YetAnotherUser24/nodo-mezclador/scripts/results/figures/pso/sysid_itae_step.png

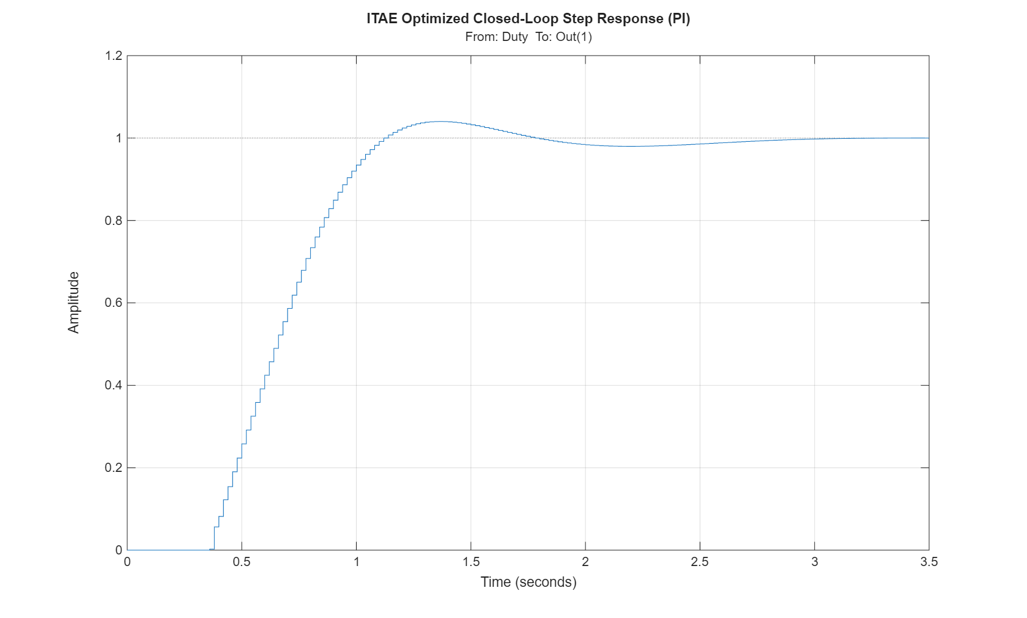
scripts/results/figures/pso/sysid_itae_step.png
