YetAnotherUser24/nodo-mezclador/scripts/data/closed_loop_test.csv

Time_s | Target_Duty | Compensated_Duty | Rad_s
0.000 | 0.0400 | 0.2841 | 0.0000
0.020 | 0.0800 | 0.3140 | 0.0000
0.040 | 0.1200 | 0.3439 | 0.0000
0.060 | 0.1600 | 0.3738 | 0.0000
0.080 | 0.2000 | 0.4036 | 0.0000
0.100 | 0.2400 | 0.4334 | 0.0000
0.120 | 0.2800 | 0.4632 | 0.0000
0.140 | 0.3200 | 0.4930 | 0.0000
0.160 | 0.3600 | 0.5228 | 0.0000
0.180 | 0.4000 | 0.5525 | 0.0000
0.200 | 0.4400 | 0.5822 | 0.0000
0.220 | 0.4800 | 0.6119 | 29.0946
0.240 | 0.5200 | 0.6415 | 29.0946
0.260 | 0.5600 | 0.6712 | 31.1126
0.280 | 0.6000 | 0.7008 | 31.8478
0.300 | 0.6400 | 0.7304 | 32.2286
0.320 | 0.6800 | 0.7599 | 32.2286
0.340 | 0.7000 | 0.7747 | 32.4605
0.360 | 0.7400 | 0.8043 | 23.2250
0.380 | 0.7800 | 0.8338 | 23.2250
0.400 | 0.8200 | 0.8632 | 36.1468
0.420 | 0.8600 | 0.8927 | 40.3071
0.440 | 0.9000 | 0.9222 | 58.3007
0.460 | 0.9400 | 0.9516 | 61.0985
0.480 | 0.9800 | 0.9810 | 65.7485
0.500 | 1.0000 | 0.9957 | 76.1257
0.520 | 1.0000 | 0.9957 | 86.0427
0.540 | 1.0000 | 0.9957 | 99.6114
0.560 | 1.0000 | 0.9957 | 106.7425
0.580 | 1.0000 | 0.9957 | 117.9498
0.600 | 1.0000 | 0.9957 | 127.3731
0.620 | 1.0000 | 0.9957 | 136.2267
0.640 | 0.9660 | 0.9707 | 145.1484
0.660 | 0.9592 | 0.9656 | 155.0523
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
