YetAnotherUser24/nodo-mezclador/scripts/results/figures/pidtune/closed_loop_validation copy.png

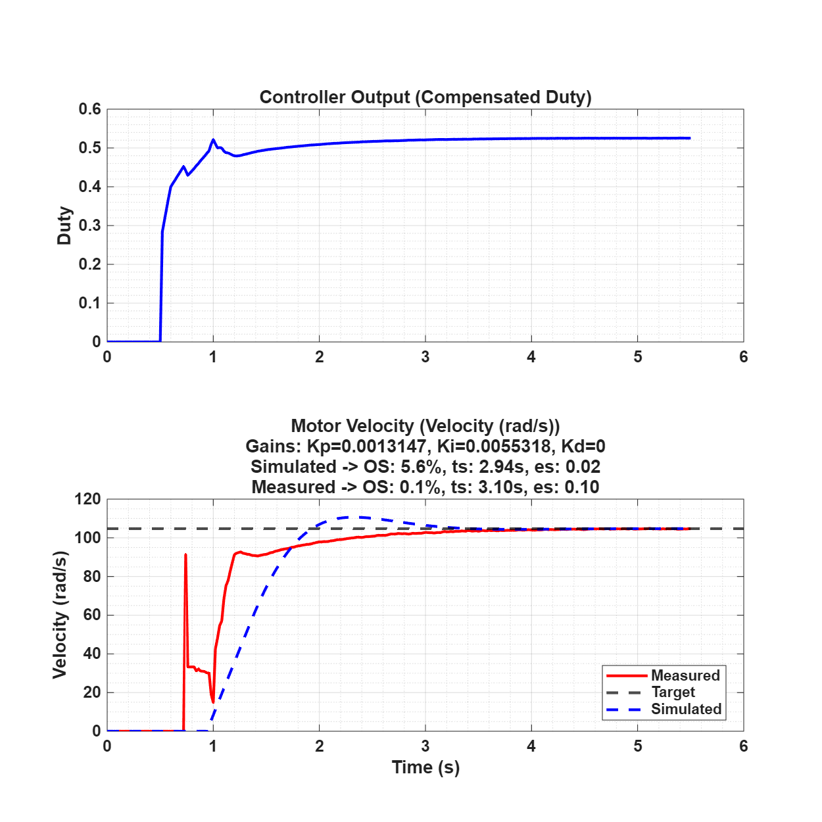
scripts/results/figures/pidtune/closed_loop_validation copy.png
