YetAnotherUser24/nodo-mezclador/scripts/results/figures/pidtune/closed_loop_validation_new_plant.png

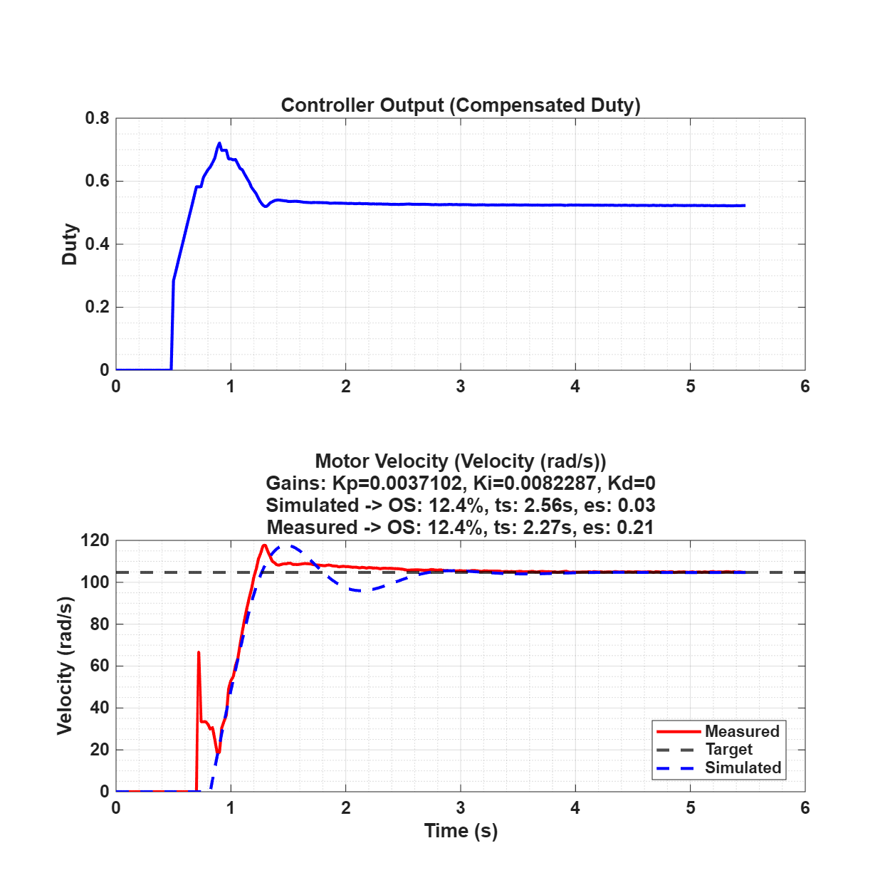
scripts/results/figures/pidtune/closed_loop_validation_new_plant.png
