YetAnotherUser24/nodo-mezclador/scripts/results/figures/pidtune/closed_loop_validation_open_air.png

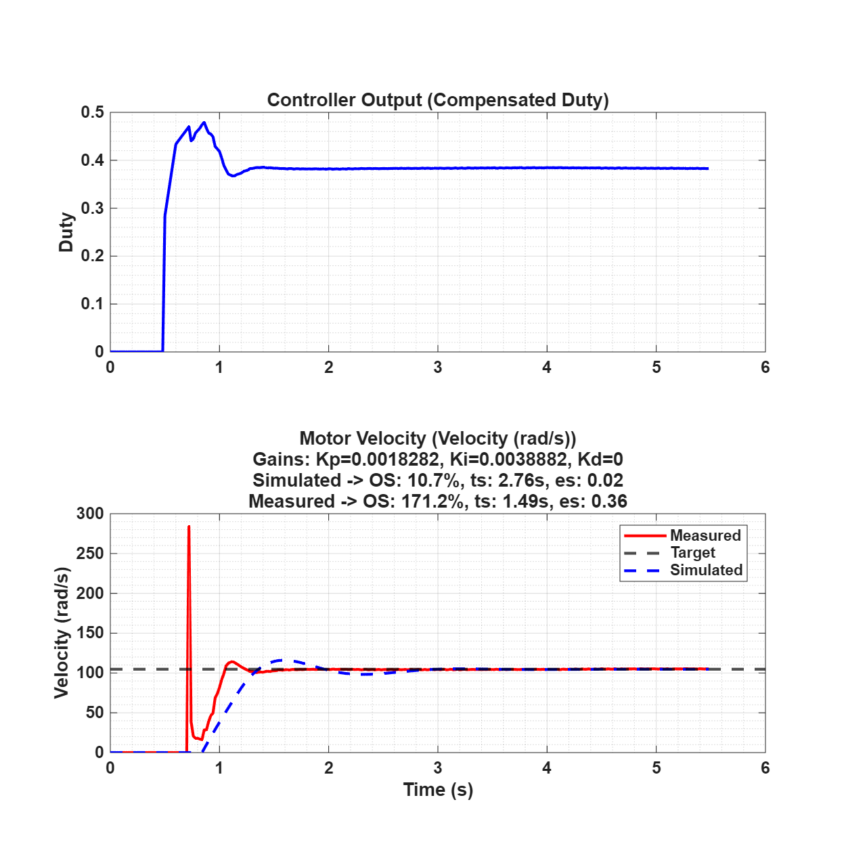
scripts/results/figures/pidtune/closed_loop_validation_open_air.png
