YetAnotherUser24/nodo-mezclador/scripts/results/figures/pidtune/sysid_closed_loop.png

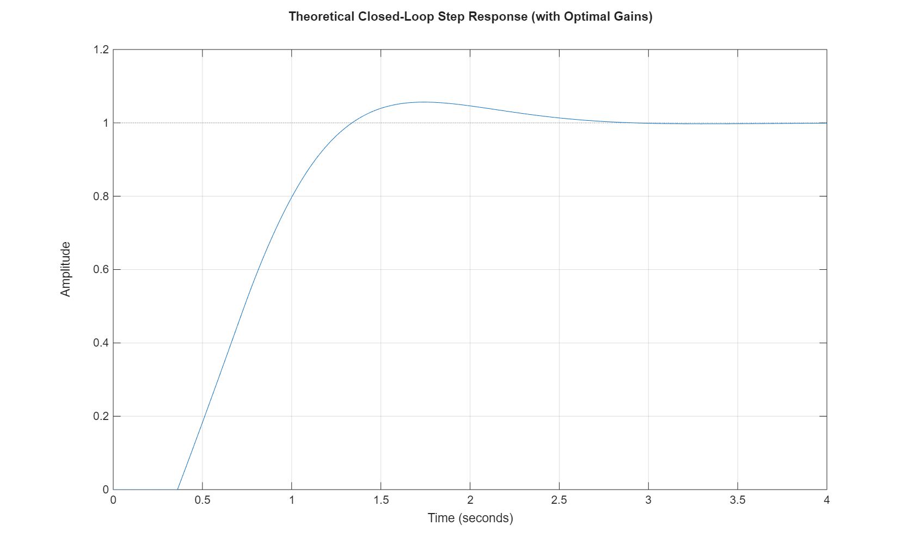
scripts/results/figures/pidtune/sysid_closed_loop.png
