YetAnotherUser24/nodo-mezclador/scripts/results/figures/pidtune/sysid_model_fit.png

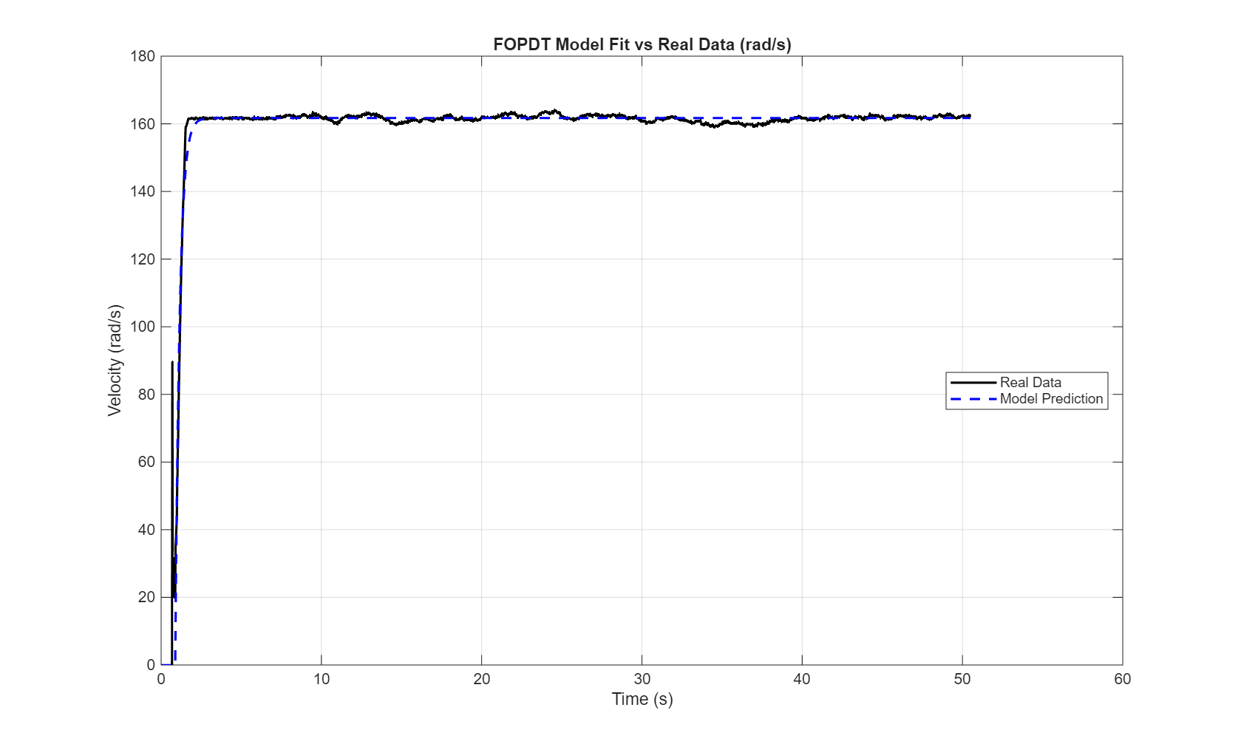
scripts/results/figures/pidtune/sysid_model_fit.png
