YetAnotherUser24/nodo-mezclador/scripts/results/figures/pidtune/sysid_raw_data.png

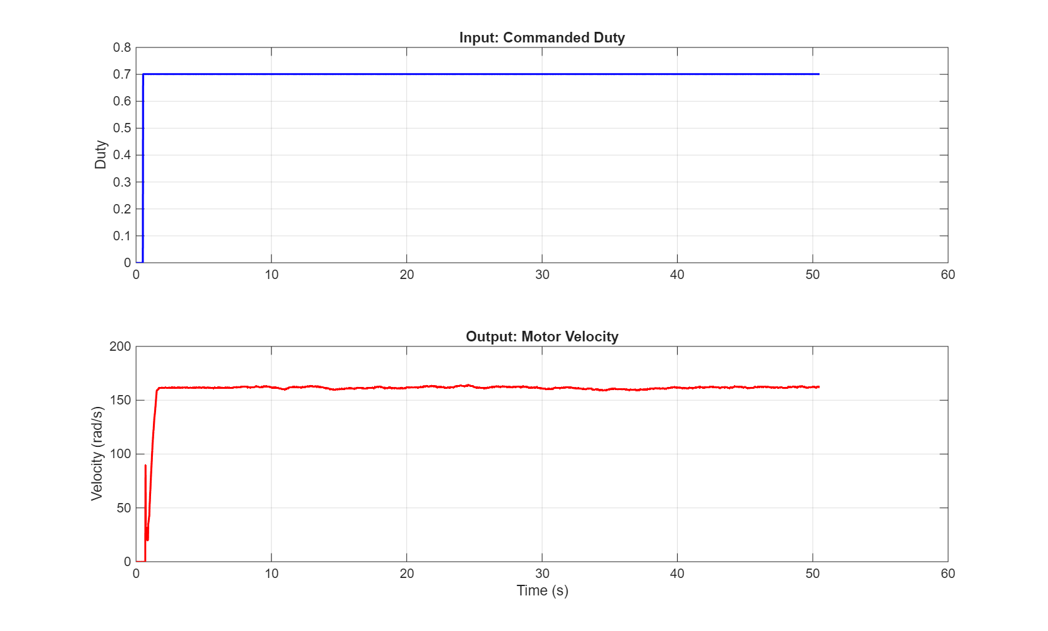
scripts/results/figures/pidtune/sysid_raw_data.png
