YetAnotherUser24/nodo-mezclador/scripts/results/figures/pso/closed_loop_validation_new_plant.png

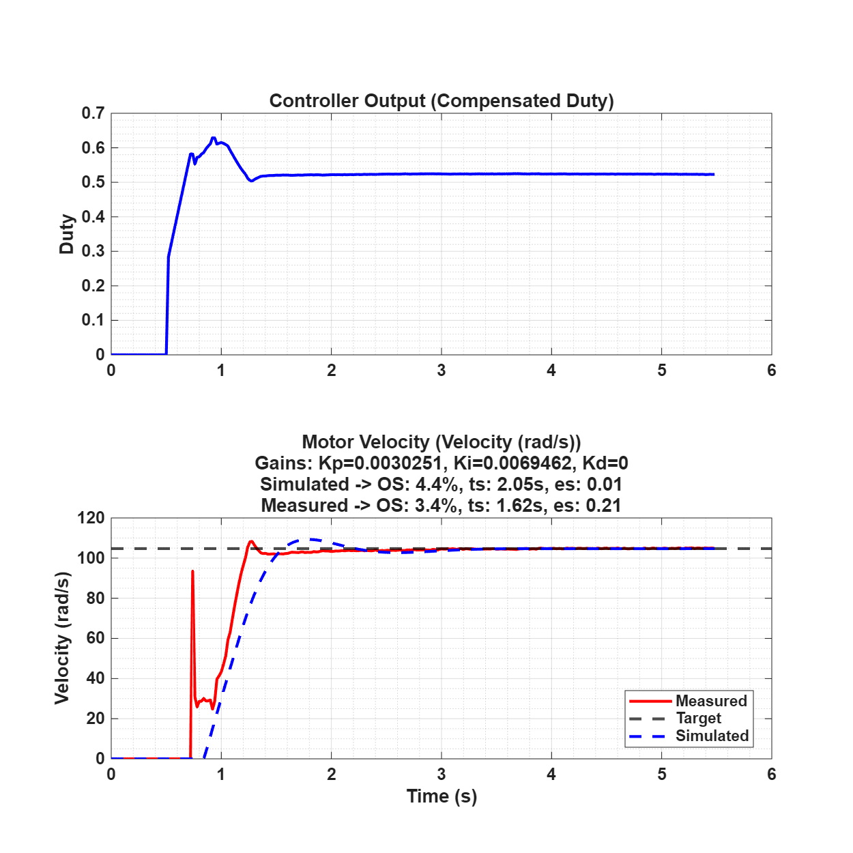
scripts/results/figures/pso/closed_loop_validation_new_plant.png
