YetAnotherUser24/nodo-mezclador/scripts/results/figures/pso/closed_loop_validation_open_air.png

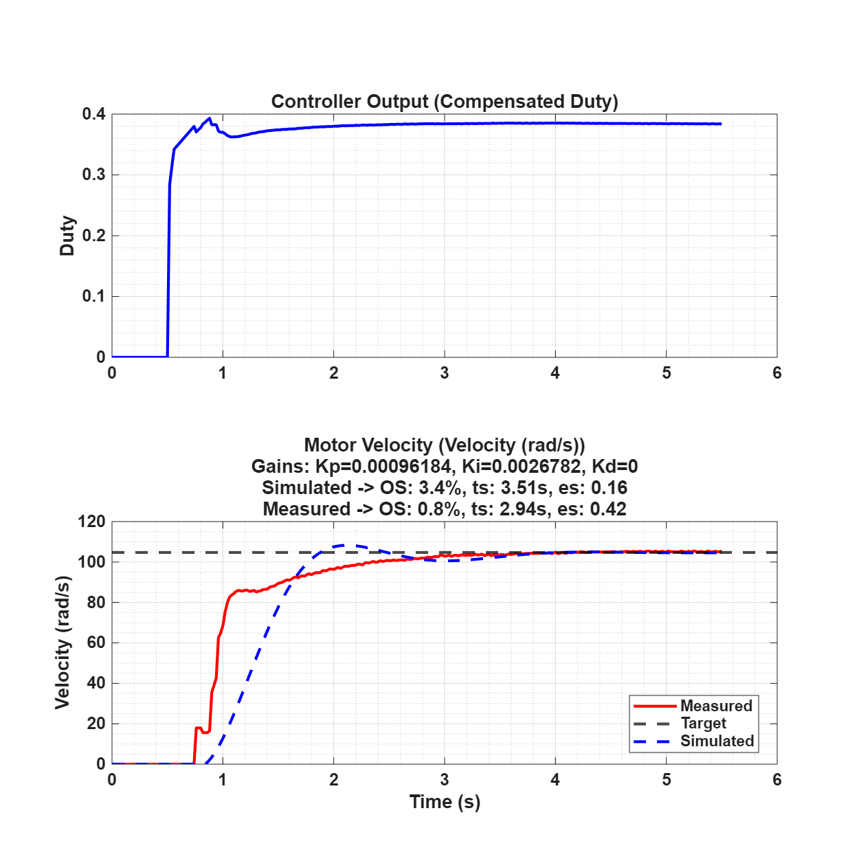
scripts/results/figures/pso/closed_loop_validation_open_air.png
