YetAnotherUser24/nodo-mezclador/scripts/results/figures/pso/optimization_comparison.png

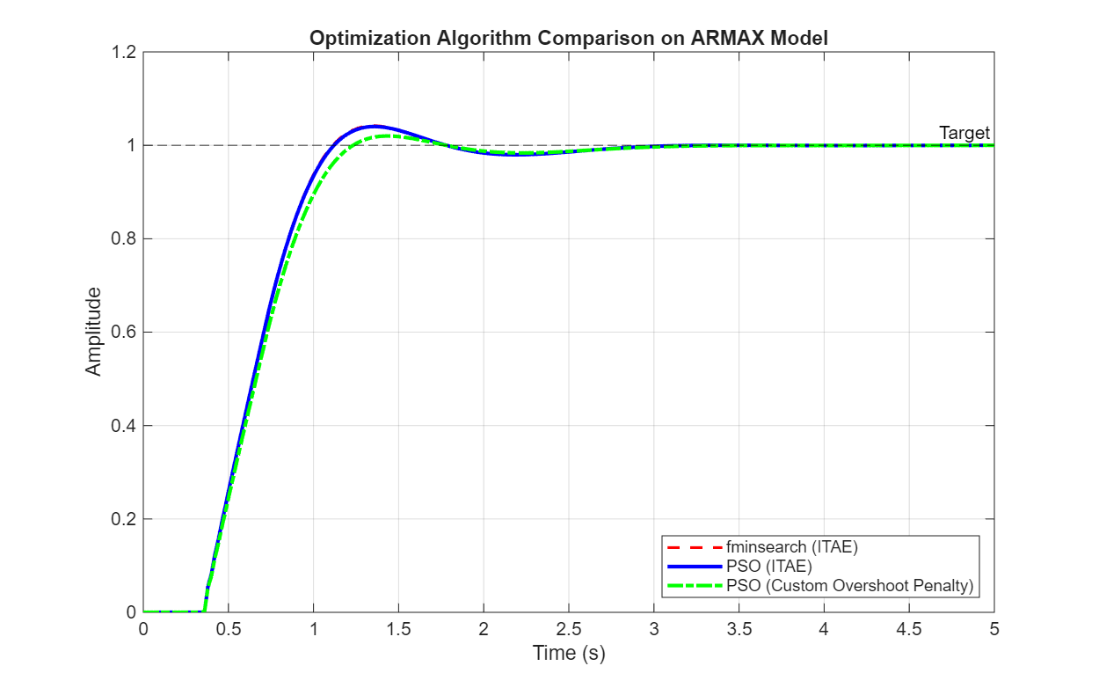
scripts/results/figures/pso/optimization_comparison.png
