YetAnotherUser24/nodo-mezclador/scripts/results/figures/pso/sysid_model_comparison.png

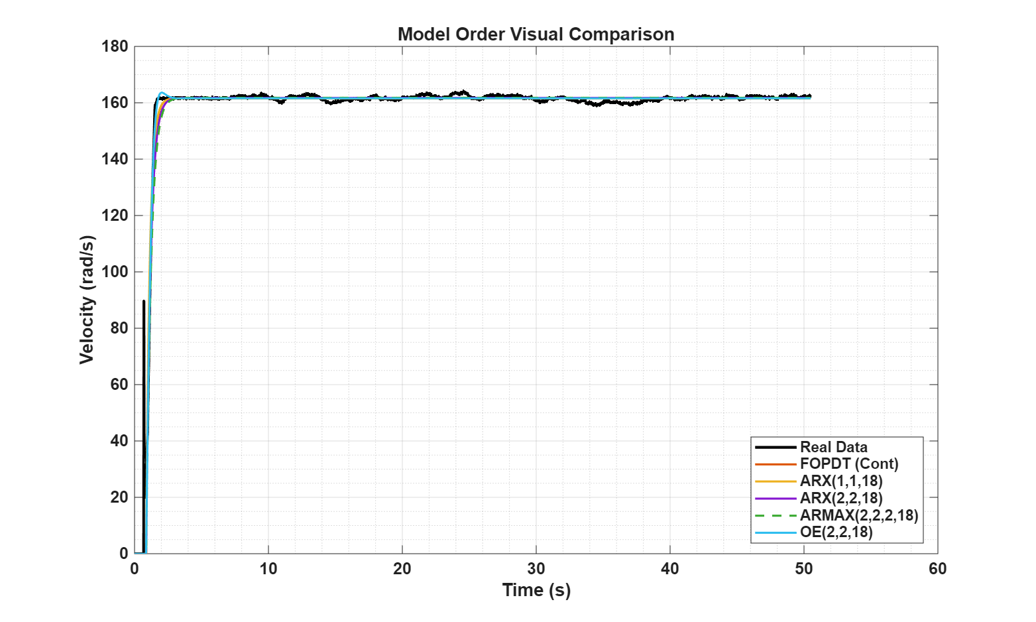
scripts/results/figures/pso/sysid_model_comparison.png
