YetAnotherUser24/nodo-mezclador/scripts/results/figures/pso/sysid_model_fit.png

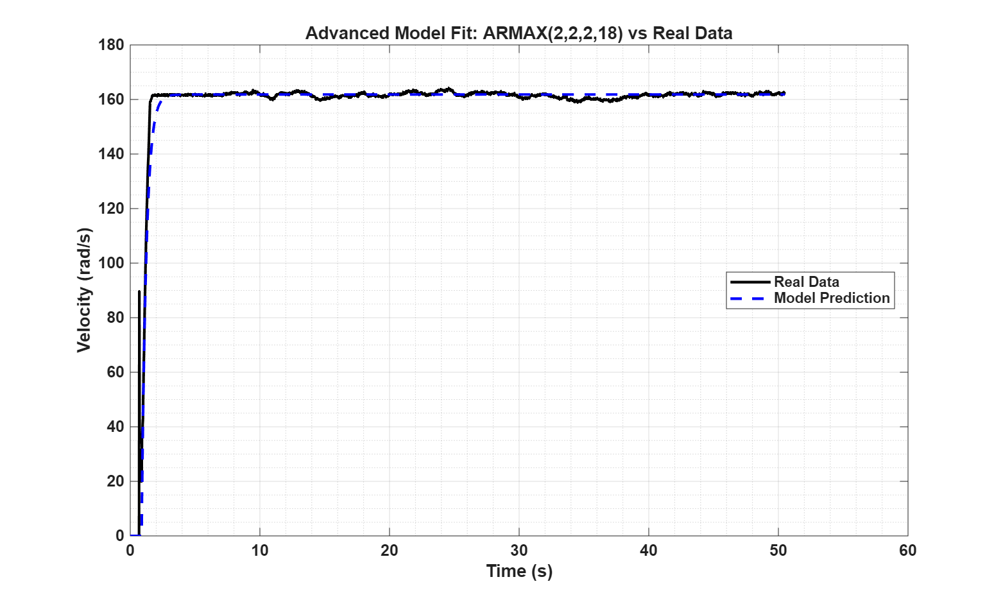
scripts/results/figures/pso/sysid_model_fit.png
