YetAnotherUser24/nodo-mezclador/(commit log)

2026-09-07 feat: initial commit for T-200 thruster velocity controller and SNR8503M driver interface
2026-10-03 feat: implement closed-loop velocity controller and reciprocal FG tachometer for T-200 thruster
2026-10-03 fix: change 220 pull up to 200
    [esp32s3_main.cpp]
2026-10-03 feat: add stall recovery, FG fault decoding, and analog knob override
    - Implemented stall fault auto-recovery by forcing 0% PWM on stall
    - Added FG fault pulse decoder to identify specific ESC errors (Stall, Overcurrent, etc)
    - Updated telemetry to display real-time ESC state machine status
    - Added analog knob manual override on GPIO 4 with 0->100->0 unlock sequence and 5s inactivity lockout
    - Updated MOTOR_MIN_SPIN_DUTY to 0.25 and PULLUP_RESISTOR_OHMS to 200 for physical threshold alignment
    [esp32s3_main.cpp]
2026-10-03 feat: add SYSID mode for 50Hz compact CSV telemetry
    - Added SYSID ON/OFF commands to toggle telemetry rate and format for system identification.
2026-10-03 feat: add Python sysid logger and MATLAB optimal tuning scripts
    End-to-end pipeline to capture open-loop step response via serial, fit a FOPDT model via System Identification Toolbox, and calculate ITAE/Phase-Margin optimal PID gains.
2026-10-03 feat: add system identification, PID tuning scripts, and data logger for T-200 controller
    [closed_loop_test.csv, step_response.csv]
2026-10-03 feat: add motor controller firmware, identification models, and validation pipeline scripts
    [closed_loop_pid.csv, closed_loop_pidtune.csv, closed_loop_pso.csv, closed_loop_test.csv, step_response.csv]
2026-10-03 feat: add PRBS and stair-step data acquisition methods with comprehensive logging and pipeline support
    [closed_loop_pidtune.csv, closed_loop_pso.csv, step_response.csv]
2026-10-03 chore(config): update device authentication key
2026-10-03 fix(core): remove ota password, mute serial telemetry, and add speed_percent fallback
    [cloud_worker.cpp, config.h, esp32s3_main.cpp]
2026-10-06 feat: implement robust non-blocking WiFi and OTA update functionality for ESP32
2026-10-08 feat(orchestrator): honor mixer state commands and report RTC execution timestamps
    The auxiliary T-200 mixer can now be driven by the orchestrator (start_mixer / stop_mixer / set_state) and publishes a mixer_events record with the exact rtc_timestamp_ms of the switch, so the deoxygenation protocol can be correlated with the DO curve.
2026-10-08 fix(mixer): only run when the orchestrator explicitly requests mixing
    Every set_state with ACTIVE_EXPERIMENT turned the mixer on regardless of the plant, and MANUAL_OVERRIDE left it spinning. That made the impeller run through aeration and closed-loop tests, where its agitation biases the KLa identification, and left it running after aborting a recipe.
    - The mixer now follows the explicit payload.mixer field sent by the orchestrator.
    - IDLE and MANUAL_OVERRIDE always stop it.
    - ACTIVE_EXPERIMENT without the field leaves the actuator untouched, because the mixing/aeration overlap is experimental and operator-controlled (AGENTS.md rule 11).
    - The default mixing speed drops from a forced 1500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
    [cloud_worker.cpp]
2026-10-09 refactor(build): simplify the environments and name the node explicitly
    Los entornos eran 13 en el nodo sensor y 12 en el aerador, con alias redundantes, nombres que no decian nada y un default_envs que apuntaba a la placa equivocada. Ahora cada nodo tiene un entorno por defecto que YA es la placa real, entornos cortos y consistentes, y un `<entorno>-ota` para el flasheo inalambrico que exige el invariante 13.
    La equivalencia no se asumio: se capturo la configuracion resuelta por PlatformIO antes y despues y se compararon banderas, librerias, placa, tabla de particiones y ajustes de subida. Ademas los 4 firmwares se reconstruyeron desde limpio y el uso de flash y RAM quedo identico byte a b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
2026-10-09 chore(git): pin line endings to LF across platforms
    Se anade .gitattributes con '* text=auto eol=lf' para que el contenido se extraiga identico en Linux, Windows y macOS. Con Git for Windows instalando core.autocrlf=true por defecto, el final de linea dependia de la configuracion de cada maquina y un archivo que llegaba a Linux con CRLF rompia los scripts (un shebang con \r falla con 'bad interpreter'). Los scripts quedan fijados a LF, los .bat/.cmd a CRLF y los binarios marcados como tales.
    Se fija core.autocrlf=false en el repositorio para no depender del ajuste global de la maquina.
2026-10-09 docs: enlaces relativos al repositorio y URL del nodo
    Los .md usaban enlaces absolutos file:///c:/Users/Sam/... que solo resolvian en esta maquina: quedaban rotos para cualquiera que viera el repositorio publicado. Ahora las referencias son relativas y se verifico que todos los enlaces .md resuelven a archivos existentes. Los SDK del SNR8503M que cita el resumen de protocolo apuntan a la copia que si esta versionada en docs/SNR8503M_Files.
    Se anade ademas la URL publica del nodo en su README.
2026-10-09 feat(virtual): add virtual build for the T-200 mixer via injected bus
    Extract the LEDC PWM, FG tachometer ISR and analog knob out of the monolithic
    `esp32s3_main.cpp` behind a device bus, so the 100 Hz PID runs unchanged in
    both builds.
    - add `IPwmActuator`, `ITachometer`, `IKnobInput` (`mixer_bus.h`) + factories
    - `mixer_bus_real.cpp`: LEDC PWM with the analytic RC linearizer, the
    reciprocal FG ISR with the fault-pulse decoder, and the ADC knob
    - `mixer_sim.{h,cpp}`: declarative duty->rpm model (deadband, first-order
    spin-up, 7 pole pairs) + fault-pulse schedule (host-testable)
    - `mixer_bus_virtual.cpp`: binds the sim to the bus
    - `esp32s3_main.cpp`: single injected-bus path, PID/CLI u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
    [esp32s3_main.cpp, mixer_bus.h, mixer_bus_real.cpp, mixer_bus_virtual.cpp, mixer_sim.cpp, mixer_sim.h, test_mixer_bus.cpp]
2026-10-09 fix(cloud): read mixer_rpm when starting the mixer, accept int or float
    `mixer_rpm` was only parsed inside the `set_state` branch, so an explicit
    `start_mixer` command always fell back to MIXER_DEFAULT_RPM (600). Also,
    `is<float>()` is false for JSON integers, so a whole-number rpm was ignored
    even on the path that did read it.
    Parse `mixer_rpm` where the payload is first opened (covering start_mixer /
    stop_mixer / set_state) and accept both int and float.
    Verified on hardware: start_mixer with mixer_rpm=1500 now targets
    157.08 rad/s (1500 RPM) and the PI settles with zero error at 175 Hz FG.
    [cloud_worker.cpp, serial_probe.py, workflow_test.py]
2026-10-09 fix(cloud): report the full motor-card telemetry contract
    The mixer only sent target/actual rpm, duty and gains, so the dashboard's
    motor card showed a running mixer with speed_percent=0, pwm_us stuck at 1500
    and null power. Add the fields the dashboard actually reads (is_on,
    speed_percent derived from RPM over the T-200 ceiling, pwm_us derived from the
    commanded duty) alongside the existing ones.
    Verified live: start_mixer 1200 RPM now reports on=true, pct=31.58,
    pwm=1741, rpm=1200, target=1200.
    [cloud_worker.cpp]
2026-10-10 feat(mqtt): migrate the mixer node to the schema-v2 transport
    Replace the HTTPS telemetry POST and the 1 Hz command poll with the shared
    schema-v2 MQTT transport, behind AQUA_TRANSPORT_MQTT so the legacy path is one
    flag away.
    - vendor lib/aqua_protocol from the canonical copy in the station repo
    - add the broker block to config.h with a guard per setting, not just around the
    block: an outer #ifndef skips the whole block and silently ignores every -D
    override, which is what the pump hit
    - add src/aqua_link.{h,cpp}: envelope batching, presence with LWT, and a
    per-sample t_dev_ms so a batch does not collapse onto one instant
    - extract applyMixerCommand() from the inline HTTP poll so the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
    [aqua_link.cpp, aqua_link.h, cloud_worker.cpp, cloud_worker.h, config.h]
2026-10-10 fix(wdt): feed the task watchdog so the node stops rebooting every 60 s
    esp_task_wdt_add(NULL) in setup() registers loopTask, and nothing in loop()
    reset it, so the task watchdog fired on a fixed 60.3 s cycle whether or not the
    broker was reachable. Measured on the bench as boots 60.3 s apart with
    "task_wdt: - loopTask (CPU 1) ... Aborting" - a scheduled reboot, and worse than
    the outage it was meant to survive because a reset discards the store-and-forward
    batch.
    Feed the watchdog at the top of loop(). The idle tasks stay on the watch list via
    idle_core_mask, which is what still catches the real fault: a core-0 task
    blocking long enough to starve idle0.
    Bench: 0 reboots and 0 task_wdt mes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
    [esp32s3_main.cpp]
2026-10-10 fix(mqtt): reject a command whose deadline has already passed
    The gateway stamps `deadline_ms` when it issues a command and nothing on the
    device ever read it, so a command that arrived late -- queued while the session
    was down, or redelivered -- was carried out exactly as if it had just been
    requested. An operator's intent expires, and acting after it does is not
    neutral: it moves an actuator for a reason nobody is waiting on any more.
    Enforced once, in the transport's onMessage, so all four nodes behave the
    same. Skipped when the device clock is unanchored (before 2020): comparing an
    epoch deadline against an unanchored clock would reject every command, which is
    a worse failure than the o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
    [aqua_link.cpp]
2026-10-10 feat(time): consume the retained aqua/time broadcast
    docs/TIME-SYNC.md tier 3 had a publisher and no subscribers: the topic was
    published by the gateway from its own clock -- worthless exactly when it is
    needed -- and nothing on the mesh ever read it. This node now subscribes, caches
    the newest broadcast with the uptime it arrived at, and carries it forward on the
    monotonic clock.
    Sample stamping and the command-deadline check share one aquaLinkNowMs(), which
    prefers the node's own NTP clock and falls back to the broadcast, so a node
    with an AP and a broker but no internet no longer degrades every sample to
    `monotonic`.
    Inbound messages are now routed by topic. `aqua/time` is a broadcast,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
    [aqua_link.cpp, aqua_link.h, cloud_worker.cpp]
2026-10-10 refactor(aqua_link): use the shared clock rules
    The deadline check, the time-broadcast extrapolation and the plausibility
    threshold were four near-identical copies, one per node, and they had already
    drifted:
    - the pump declared its own threshold at 1600000000 (2020-09-13) while the other
    three used 1577836800 (2020-01-01), so a clock reading 2020-05-01 was reported
    `monotonic` on the pump and `ntp` elsewhere -- and the pump's own comment said
    the pre-2020 case was the one being handled;
    - the sensor read its clock directly and compared it inline, so "is this command
    stale?" was spelled two different ways;
    - the 256-byte JSON probe that silently disabled the check had to be correcte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
    [aqua_link.cpp]
2026-10-11 fix(config): let the WiFi credentials be overridden at build time
    `WIFI_SSID`/`WIFI_PASSWORD` were unguarded `#define`s, so
    `-DAQUA_WIFI_SSID=...` was accepted by the compiler and then silently
    overwritten by this header. The board joined the old network and nothing in the
    build output said why.
    The MQTT block in the same file already carries the guard *and* a comment
    explaining that guarding only an enclosing `#if` does not work, because the
    preprocessor skips the body and the inner defines never redefine. The WiFi
    defines sat just above that note, unguarded.
    Behind `AQUA_WIFI_SSID`/`AQUA_WIFI_PASSWORD`, with `WIFI_SSID`/`WIFI_PASSWORD`
    kept as aliases so every existing reference compiles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
